BallHamster/PiPoE/PiPOE.csv

Source: | C:\Users\Bootnrr\Desktop\Halflife\week 5\PiPOE\PiPOE.kicad_sch
Date: | 2026-11-08T17:21:56
Tool: | Eeschema 10.0.5
Generator: | C:\Program Files\KiCad\10.0\bin\scripting\plugins/bom_csv_grouped_by_value_with_fp.py
Component Count: | 16
Ref | Qnty | Value | Cmp name | Footprint | Description | Vendor | DNP
AG1 | 1 | ~ | Ag5400 | Rpi_poe:Ag5400
C2 | 1 | 470 uF | C_Polarized | Capacitor_THT:CP_Radial_D8.0mm_P3.50mm | Polarized capacitor
C3 | 1 | 100 nF | C_Polarized | Capacitor_SMD:C_0805_2012Metric | Polarized capacitor
C4 | 1 | 10 uF | C_Polarized | Capacitor_SMD:C_0805_2012Metric | Polarized capacitor
D1, D2, D3, D4, D5, D6, D7, D8 | 8 | SS210 | SS210 | Diode_SMD:D_SMA | 100V 2A Schottky Diode, SMA
D9 | 1 | SMAJ58A | SMAJ58A | Diode_SMD:D_SMA | 400W unidirectional Transient Voltage Suppressor, 58.0Vr, SMA(DO-214AC)
D10 | 1 | LED | LED | LED_SMD:LED_0805_2012Metric | Light emitting diode
R1 | 1 | 27 kOhm | R | Resistor_SMD:R_1206_3216Metric | Resistor
U1 | 1 | Rpi_poe 4b | Rpi_poe 4b | Rpi_poe:rpi_poe | The Raspberry Pi 4 Module B SC0193(9) single board computer features a powerful Broadcom BCM2711 ARM Cortex-A72 quad-core processor running at 1.5GHz, making it an excellent choice for a variety of embedded computing applications. With 2GB of RAM and a compact size of 85.00mm x 56.00mm, it offers performance in a small form factor. This SBC includes 40 digital I/O lines, Gigabit Ethernet, multiple USB ports (two USB 2.0 and two USB 3.0), and supports video outputs via CSI, DSI, and HDMI interfaces.
