BallHamster/PiPoE/PiPOE.kicad_pcb

## KiCad design PiPOE.kicad_pcb (2026-11-08)

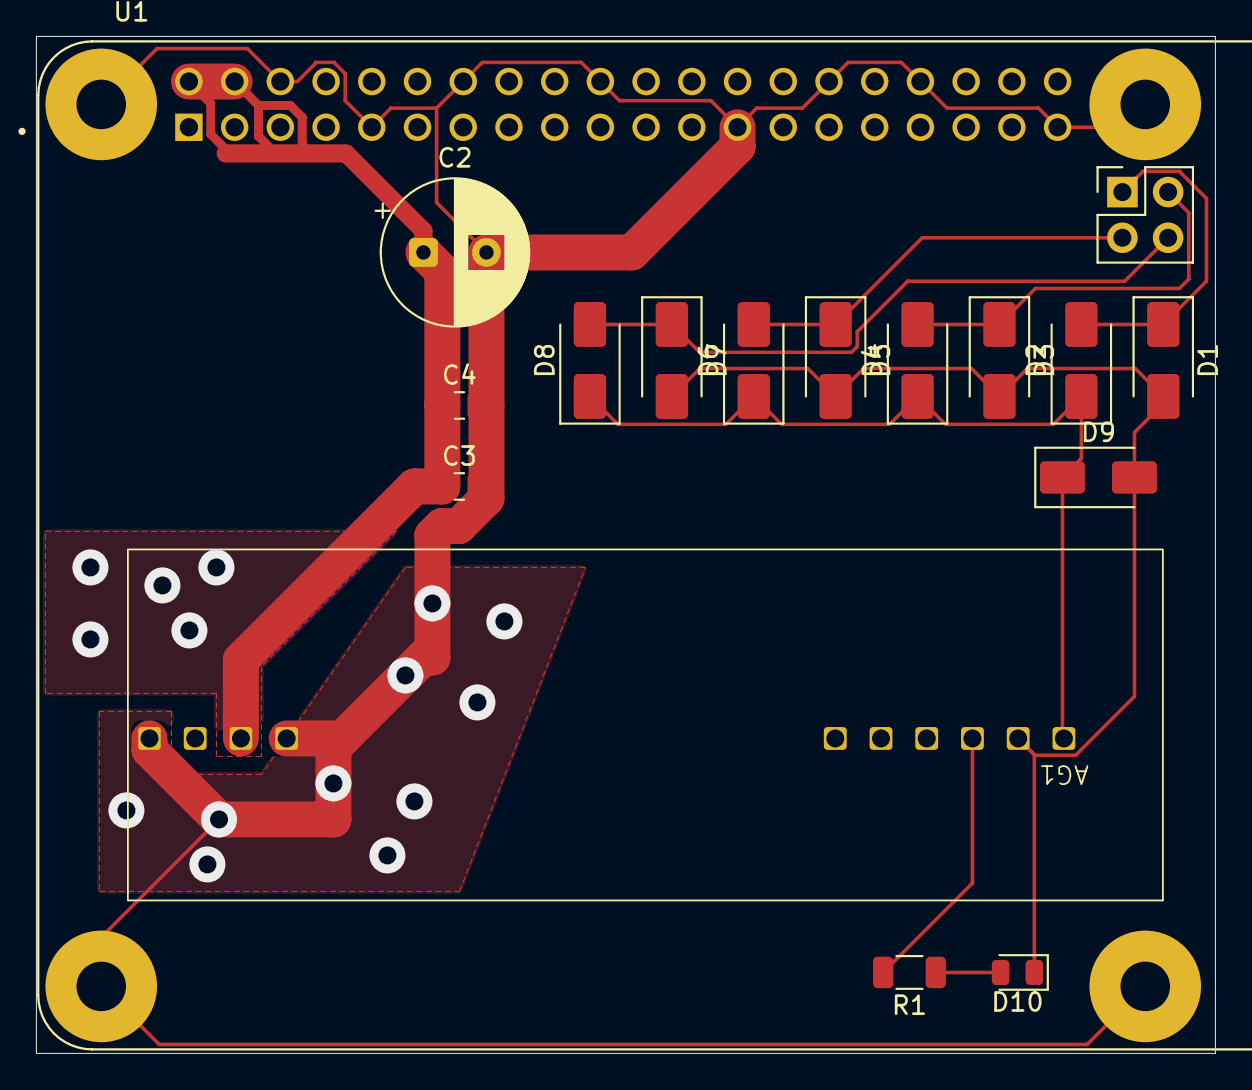
[picture p8: board PiPOE.kicad_pcb from above]

Board: 2 copper layers, 65.5 x 56.5 mm, 16 parts (0 on the bottom side), 10 nets.

Parts:
AG1: Ag5400
C2: 470 uF; CP_Radial_D8.0mm_P3.50mm
C3: 100 nF; C_0805_2012Metric
C4: 10 uF; C_0805_2012Metric
D1, D2, D3, D4, D5, D6, D7, D8: SS210; D_SMA
D9: SMAJ58A; D_SMA
D10: LED; LED_0805_2012Metric
R1: 27 kOhm; R_1206_3216Metric
U1: Rpi_poe 4b; rpi_poe

Connections:
+5V: AG1.8 (+VDC), C2.1, C3.1, C4.1, U1.2 (5V0), U1.4 (5V0)
/Anode: AG1.2 (VIN-), D1.2 (A), D3.2 (A), D5.2 (A), D7.2 (A), D9.2 (A2), D10.1 (K)
/Cathode: AG1.1 (VIN+), D2.1 (K), D4.1 (K), D6.1 (K), D8.1 (K), D9.1 (A1)
GND: AG1.7 (-VDC), AG1.10 (-VDC), C2.2, C3.2, C4.2, U1.6 (GND), U1.9 (GND), U1.14 (GND), U1.20 (GND), U1.25 (GND), U1.30 (GND), U1.34 (GND), U1.39 (GND), U1.S1 (SHIELD), U1.S2 (SHIELD), U1.S3 (SHIELD), U1.S4 (SHIELD)
unnamed: AG1.3 (AT-DET), R1.2
unnamed: D1.1 (K), D2.2 (A), U1.51 (POE01/TR01)
unnamed: D3.1 (K), D4.2 (A), U1.52 (POE02/TR00)
unnamed: D5.1 (K), D6.2 (A), U1.53 (POE03/TR03)
unnamed: D7.1 (K), D8.2 (A), U1.54 (POE04/TR02)
unnamed: D10.2 (A), R1.1
