BallHamster/PiPoE/(commit log)

2026-11-08 Add new components to PiPOE BOM
    [PiPOE_BOM_LCSC.csv]
2026-11-08 Fix formatting of AG1 entry in BOM CSV
    [PiPOE_BOM_LCSC.csv]
2026-11-08 Add total cost line to PiPOE BOM
    Added total cost line to the BOM.
    [PiPOE_BOM_LCSC.csv]
2026-11-08 Update total cost in PiPOE_BOM_LCSC.csv
    [PiPOE_BOM_LCSC.csv]
2026-11-08 Add BOM section to README
    Added Bill of Materials (BOM) section with component details.
2026-11-08 Add BOM section to README
    Added a Bill of Materials (BOM) section with component details.
